Kakackle/PEUS-2021-22-MM-239409/diy_layout_final.JPG

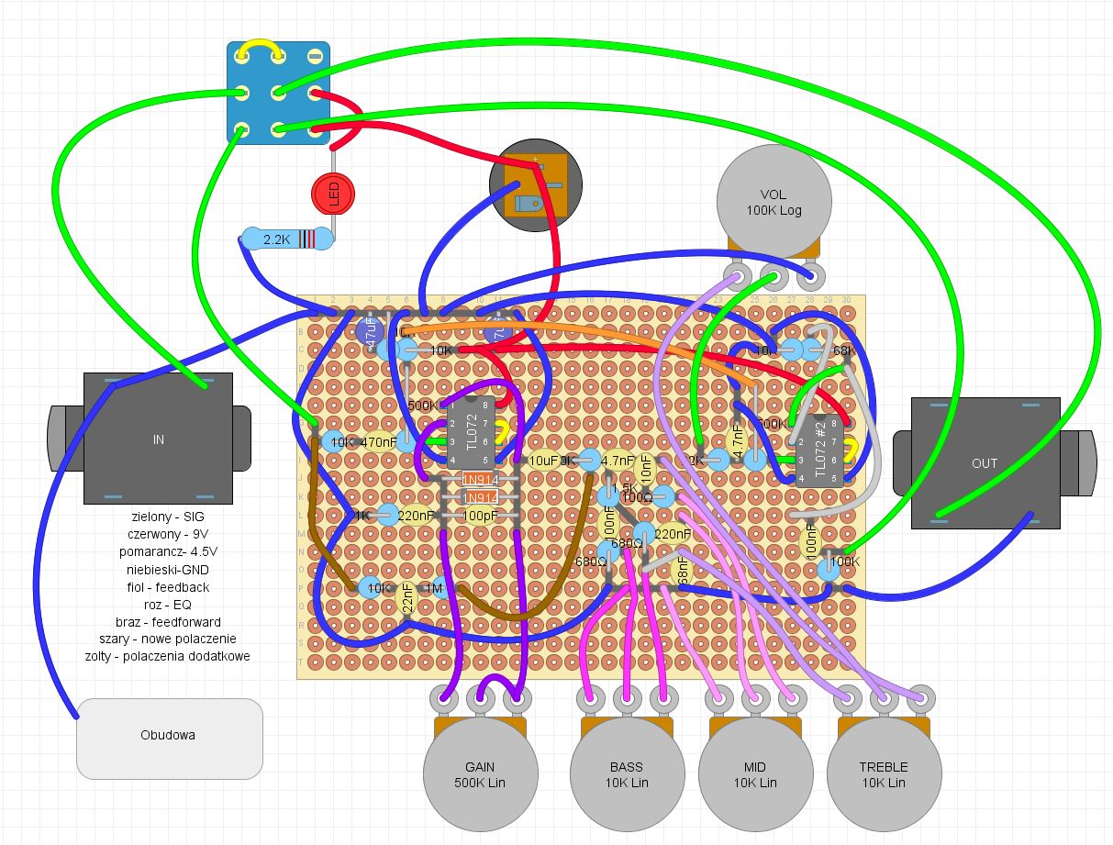
diy_layout_final.JPG
