Kakackle/PEUS-2021-22-MM-239409/README.md

# PEUS-2021-22-MM-239409
Projekt efektu gitarowego na zajęcia z przedmiotu Projektowanie Elektronicznych Układów Sterowania

AiSR WEEIA semestr letni 2021/22

grupa czwartek 16:15

Maciej Markowski 239409

Celem jest stworzenie symulacji oraz fizycznej wersji efektu wraz ze zrozumieniem i opisem działania 
oraz wpływu doboru elementów
