Kakackle/PEUS-2021-22-MM-239409/overdrive_wampler.png

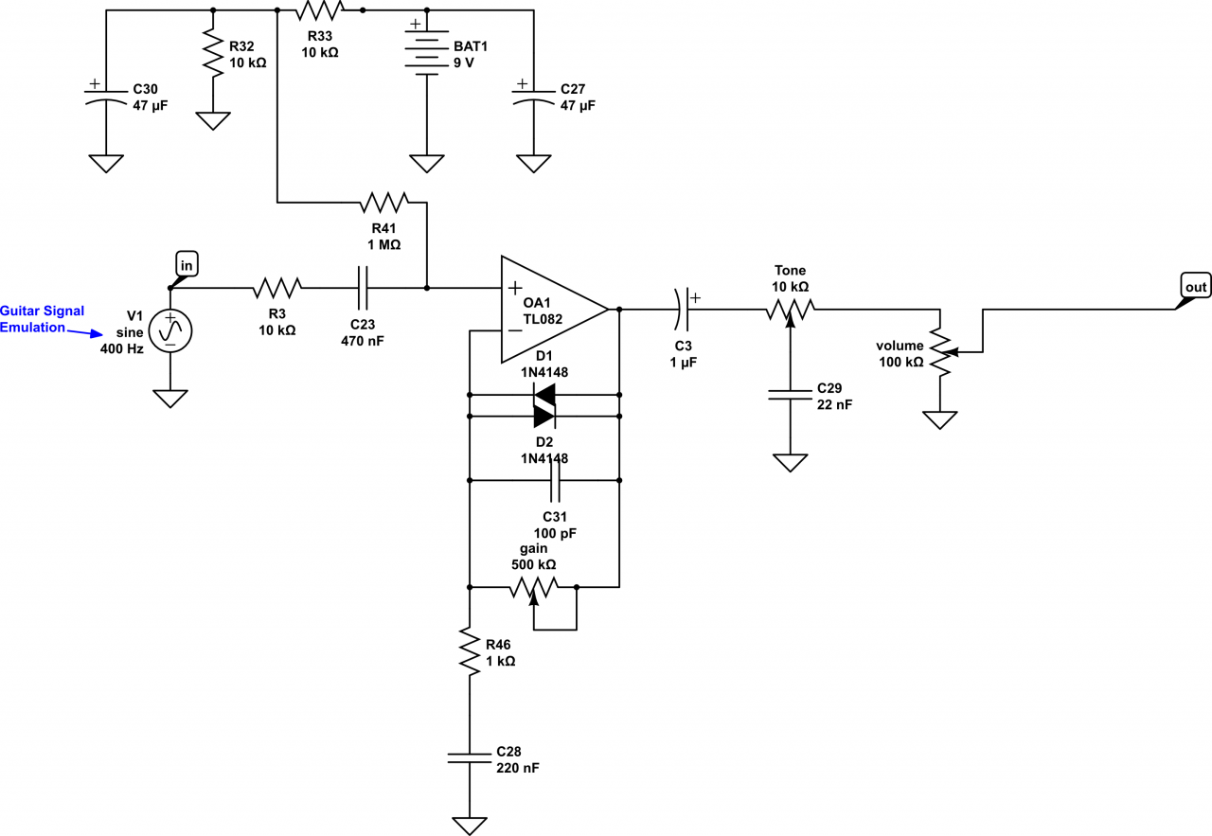
overdrive_wampler.png
