Kakackle/PEUS-2021-22-MM-239409/overdrive1_EQ_buffer.asc

C1: cap; 470n
C2: cap; 100p
C3: cap; 220n
C4: cap; 470p
C5: polcap; 47µ
C6: polcap; 47µ
C7: polcap; 1µ
C8: cap; 4.7n
C9: cap; 10n
C10: cap; 100n
C11: cap; 220n
C12: cap; 68n
C13: cap; 0.1µ
D1: diode; 1N4148
D2: diode; 1N4148
R1: res; 10k
R2: res; 10k
R3: res; 100k
R4: res; 10k
R5: res; 10k
R6: res; 1Meg
R7: res; 1.5k
R8: res; 1k
R9: res; 100
R10: res; 9k
R11: res; 1k
R12: res; 680
R13: res; 5k
R14: res; 5k
R15: res; 680
R16: res; 5k
R17: res; 5k
R18: res; 20k
R19: res; 80k
R20: res; 22k
R21: res; 68k
R22: res; 10k
R25: res; 1Meg
R: res; 250k
U1: TL072
U2: TL072
V1: voltage; wavefile=clean.wav chan=0
V2: voltage; 9V
V3: voltage; ""; AC 1
Named nets: 0, in, out
.wave clean_overdriveEQ.wav 16 44100 out
.ac dec 100 20 20k
.option plotwinsize = 0
.option numdgt = 12
treble
bass
mid
.tran 0 10 0 10u
level
