Kakackle/PEUS-2021-22-MM-239409/overdrive1_hard_n_soft.asc

C1: cap; 470n
C2: cap; 100p
C3: cap; 220n
C4: cap; 22n
C5: polcap; 47µ
C6: polcap; 47µ
C7: polcap; 1µ
C8: polcap; 1µ
C9: cap; 100p
C10: cap; 220n
D1: LED; AOT-2015
D2: LED; AOT-2015
D3: diode; 1N4148
D4: diode; 1N4148
R1: res; 10k
R2: res; 10k
R3: res; 20k
R4: res; 10k
R5: res; 10k
R6: res; 1Meg
R7: res; 80k
R8: res; 1k
R9: res; 250k
R10: res; 1k
R11: res; 1Meg
R: res; 250k
U1: TL072
U2: TL072
V1: voltage; wavefile=clean.wav chan=0
V2: voltage; 9V
V3: voltage; SINE(0 0.25 1k)
Named nets: 0, in, out, in2
.wave clean_hard_n_soft.wav 16 44100 out
.tran 5
