Kakackle/PEUS-2021-22-MM-239409/greenringer.asc

C1: cap; 0.1µ
C2: cap; 0.047µ
C3: cap; 0.047µ
C4: cap; 0.047µ
C5: polcap; 100µ
D1: diode; 1N914
D2: diode; 1N914
Q1: npn; 2N5089
Q2: npn; 2N3904
Q3: npn; 2N5089
R1: res; 560k
R2: res; 18k
R3: res; 10k
R4: res; 22k
R5: res; 68k
R6: res; 68k
R7: res; 10k
R8: res; 22k
R9: res; 6k2
R10: res; 160k
R11: res; 2Meg2
R12: res; 10k
R13: res; 47k
V1: voltage; 9V
V2: voltage; wavefile=clean.wav chan=0
V3: voltage; SINE(0 0.5 1k)
Named nets: 0, in, out
.wave sine_oct.wav 16 44100 out
.tran 0.1
