Kakackle/PEUS-2021-22-MM-239409/tube_screamer.asc

C1: cap; 22n
C2: cap; 1µ
C3: cap; 0.047
C4: cap; 51p
C5: cap; 0.22µ
C6: cap; 0.22µ
C8: cap; 1µ
C9: cap; 0.1µ
C10: polcap; 10µ
C11: polcap; 47µ
D1: diode; 1N914
D2: diode; 1N914
D3: diode; 1N914
Q1: npn; 2N3904
Q2: npn; 2N3904
R1: res; 1k
R2: res; 510k
R3: res; 10k
R4: res; 10k
R5: res; 4k7
R6: res; 51k
R7: res; 250k
R8: res; 1k
R9: res; 10k
R10: res; 10k
R11: res; 10k
R12: res; 220
R13: res; 1k
R14: res; 1k
R15: res; 80k
R16: res; 20k
R17: res; 510k
R18: res; 10k
R19: res; 100
R20: res; 10k
R21: res; 10k
R22: res; 10k
R23: res; 2Meg2
U1: RC4558
U2: RC4558
V1: voltage; wavefile=clean.wav chan=0
V2: voltage; SINE(0 0.5 1k)
V3: voltage; 9V
Named nets: 0, in, in2, out
.wave clean_screamer_asymetrical.wav 16 44100 out
.tran 2
gain 0-500k
tone 0-20k
level 0-100k
input buffer
output buffer
