Kakackle/PEUS-2021-22-MM-239409/overdrive1.asc

C1: cap; 470n
C2: cap; 100p
C3: cap; 220n
C4: cap; 22n
C5: polcap; 47µ
C6: polcap; 47µ
C7: polcap; 1µ
D1: diode; 1N4148
D2: diode; 1N4148
R1: res; 10k
R2: res; 10k
R3: res; 100k
R4: res; 10k
R5: res; 10k
R6: res; 1Meg
R8: res; 1k
R: res; 250k
U1: TL072
V1: voltage; wavefile=clean.wav chan=0
V2: voltage; 9V
Named nets: 0, in, out
.wave clean_overdrive.wav 16 44100 out
.tran 20
